ELEC391-SCARA-Robot/ELEC/Capture.PNG

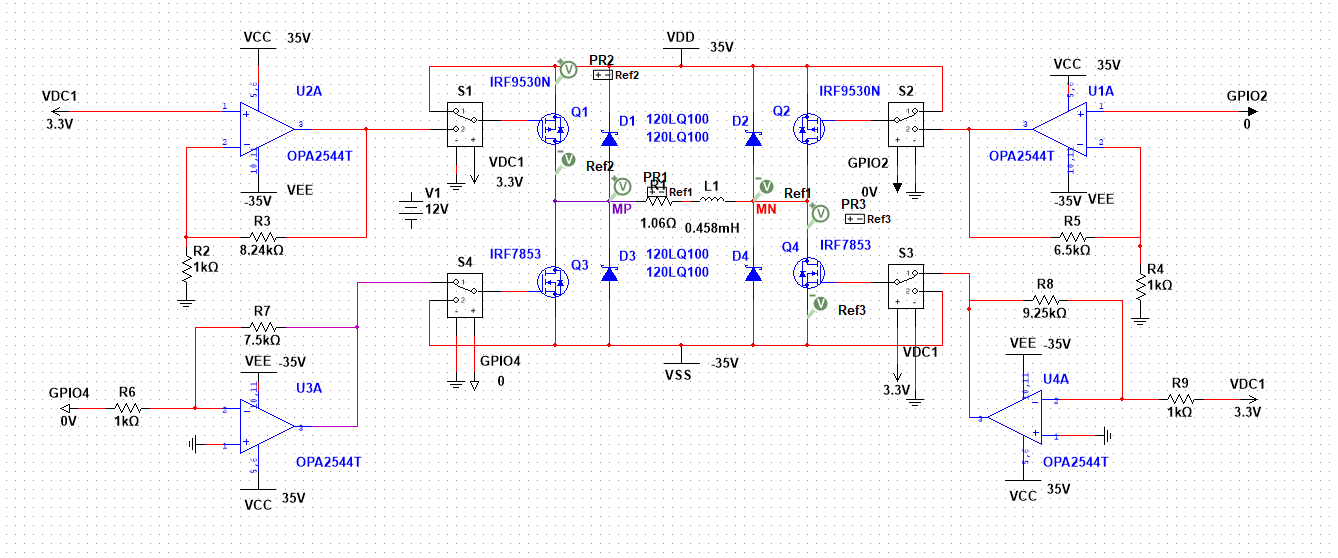
Capture.PNG
