ELEC391-SCARA-Robot/ELEC/(list of files, drawings)

Other design files:
H-Bridge24V.ms14
H-Bridge.ms14
Power Circuit.ms14
Sesnsor Digital Circuit.ms14
