ELEC391-SCARA-Robot/ELEC/(commit log)

2022-03-15 H-bridge, Power Circuit and Sensor
    [H-Bridge.ms14, Power Circuit.ms14, Sesnsor Digital Circuit.ms14]
2022-03-30 Fully Functional 24V H-Bridge
    24V H-bridge working for our models.
    [H-Bridge.ms14, H-Bridge24V.ms14, Sesnsor Digital Circuit.ms14]
